tomkentpayne/wireless_gps_tracking/README.md

wireless_gps_tracking
=====================
