tomkentpayne/wireless_gps_tracking/Eagle/README.txt

Order number: 100021590

Note:
  Layers: 2
  Silk screen: top and bottom
  Soldermask: top and bottom
  File "car.GML" is the board outline
  Drill format: Excellon, 2.4 precision.
