tomkentpayne/wireless_gps_tracking/Server/route.PNG

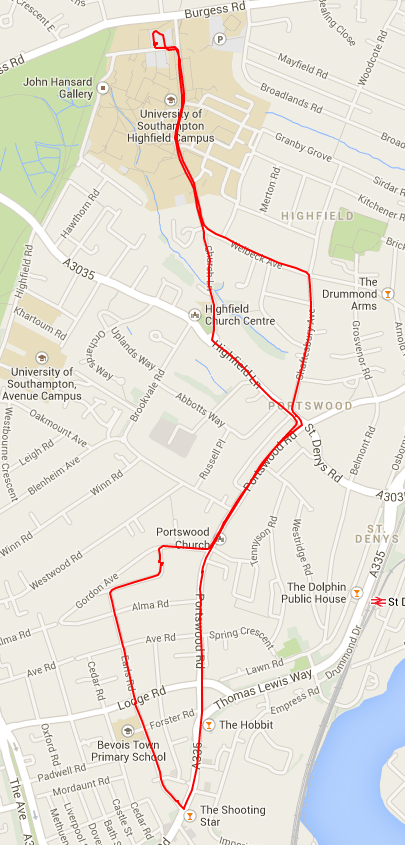
Server/route.PNG
