tomkentpayne/wireless_gps_tracking/Device Code/MAIN/Build/wireless.htm

# Static Call Graph for image .\Build\wireless.axf

#<CALLGRAPH># ARM Linker, 5.03 [Build 76]: Last Updated: Fri Dec 06 12:32:55 2013

### Maximum Stack Usage = 20 bytes + Unknown(Cycles, Untraceable Function Pointers)

### Call chain for Maximum Stack Depth:

SystemInit ⇒ SetSysClock

### Mutually Recursive functions

- ADC_IRQHandler ⇒ ADC_IRQHandler
- BusFault_Handler ⇒ BusFault_Handler
- HardFault_Handler ⇒ HardFault_Handler
- MemManage_Handler ⇒ MemManage_Handler
- UsageFault_Handler ⇒ UsageFault_Handler
- main ⇒ main

### Function Pointers

- ADC_IRQHandler from startup_stm32f40xx.o(.text) referenced from startup_stm32f40xx.o(RESET)
- BusFault_Handler from stm32f4xx_it.o(i.BusFault_Handler) referenced from startup_stm32f40xx.o(RESET)
- CAN1_RX0_IRQHandler from startup_stm32f40xx.o(.text) referenced from startup_stm32f40xx.o(RESET)
- CAN1_RX1_IRQHandler from startup_stm32f40xx.o(.text) referenced from startup_stm32f40xx.o(RESET)
- CAN1_SCE_IRQHandler from startup_stm32f40xx.o(.text) referenced from startup_stm32f40xx.o(RESET)
- CAN1_TX_IRQHandler from startup_stm32f40xx.o(.text) referenced from startup_stm32f40xx.o(RESET)
- CAN2_RX0_IRQHandler from startup_stm32f40xx.o(.text) referenced from startup_stm32f40xx.o(RESET)
- CAN2_RX1_IRQHandler from startup_stm32f40xx.o(.text) referenced from startup_stm32f40xx.o(RESET)
- CAN2_SCE_IRQHandler from startup_stm32f40xx.o(.text) referenced from startup_stm32f40xx.o(RESET)
- CAN2_TX_IRQHandler from startup_stm32f40xx.o(.text) referenced from startup_stm32f40xx.o(RESET)
- CRYP_IRQHandler from startup_stm32f40xx.o(.text) referenced from startup_stm32f40xx.o(RESET)
- DCMI_IRQHandler from startup_stm32f40xx.o(.text) referenced from startup_stm32f40xx.o(RESET)
- DMA1_Stream0_IRQHandler from startup_stm32f40xx.o(.text) referenced from startup_stm32f40xx.o(RESET)
- DMA1_Stream1_IRQHandler from startup_stm32f40xx.o(.text) referenced from startup_stm32f40xx.o(RESET)
- DMA1_Stream2_IRQHandler from startup_stm32f40xx.o(.text) referenced from startup_stm32f40xx.o(RESET)
- DMA1_Stream3_IRQHandler from startup_stm32f40xx.o(.text) referenced from startup_stm32f40xx.o(RESET)
- DMA1_Stream4_IRQHandler from startup_stm32f40xx.o(.text) referenced from startup_stm32f40xx.o(RESET)
- DMA1_Stream5_IRQHandler from startup_stm32f40xx.o(.text) referenced from startup_stm32f40xx.o(RESET)
- DMA1_Stream6_IRQHandler from startup_stm32f40xx.o(.text) referenced from startup_stm32f40xx.o(RESET)
- DMA1_Stream7_IRQHandler from startup_stm32f40xx.o(.text) referenced from startup_stm32f40xx.o(RESET)
- DMA2_Stream0_IRQHandler from startup_stm32f40xx.o(.text) referenced from startup_stm32f40xx.o(RESET)
- DMA2_Stream1_IRQHandler from startup_stm32f40xx.o(.text) referenced from startup_stm32f40xx.o(RESET)
- DMA2_Stream2_IRQHandler from startup_stm32f40xx.o(.text) referenced from startup_stm32f40xx.o(RESET)
- DMA2_Stream3_IRQHandler from startup_stm32f40xx.o(.text) referenced from startup_stm32f40xx.o(RESET)
- DMA2_Stream4_IRQHandler from startup_stm32f40xx.o(.text) referenced from startup_stm32f40xx.o(RESET)
- DMA2_Stream5_IRQHandler from startup_stm32f40xx.o(.text) referenced from startup_stm32f40xx.o(RESET)
- DMA2_Stream6_IRQHandler from startup_stm32f40xx.o(.text) referenced from startup_stm32f40xx.o(RESET)
- DMA2_Stream7_IRQHandler from startup_stm32f40xx.o(.text) referenced from startup_stm32f40xx.o(RESET)
- DebugMon_Handler from stm32f4xx_it.o(i.DebugMon_Handler) referenced from startup_stm32f40xx.o(RESET)
- ETH_IRQHandler from startup_stm32f40xx.o(.text) referenced from startup_stm32f40xx.o(RESET)
- ETH_WKUP_IRQHandler from startup_stm32f40xx.o(.text) referenced from startup_stm32f40xx.o(RESET)
- EXTI0_IRQHandler from startup_stm32f40xx.o(.text) referenced from startup_stm32f40xx.o(RESET)
- EXTI15_10_IRQHandler from startup_stm32f40xx.o(.text) referenced from startup_stm32f40xx.o(RESET)
- EXTI1_IRQHandler from startup_stm32f40xx.o(.text) referenced from startup_stm32f40xx.o(RESET)
- EXTI2_IRQHandler from startup_stm32f40xx.o(.text) referenced from startup_stm32f40xx.o(RESET)
- EXTI3_IRQHandler from startup_stm32f40xx.o(.text) referenced from startup_stm32f40xx.o(RESET)
- EXTI4_IRQHandler from startup_stm32f40xx.o(.text) referenced from startup_stm32f40xx.o(RESET)
- EXTI9_5_IRQHandler from startup_stm32f40xx.o(.text) referenced from startup_stm32f40xx.o(RESET)
- FLASH_IRQHandler from startup_stm32f40xx.o(.text) referenced from startup_stm32f40xx.o(RESET)
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
- TIM8_CC_IRQHandler from startup_stm32f40xx.o(.text) referenced from startup_stm32f40xx.o(RESET)
- TIM8_TRG_COM_TIM14_IRQHandler from startup_stm32f40xx.o(.text) referenced from startup_stm32f40xx.o(RESET)
- TIM8_UP_TIM13_IRQHandler from startup_stm32f40xx.o(.text) referenced from startup_stm32f40xx.o(RESET)
- UART4_IRQHandler from startup_stm32f40xx.o(.text) referenced from startup_stm32f40xx.o(RESET)
- UART5_IRQHandler from startup_stm32f40xx.o(.text) referenced from startup_stm32f40xx.o(RESET)
- USART1_IRQHandler from startup_stm32f40xx.o(.text) referenced from startup_stm32f40xx.o(RESET)
- USART2_IRQHandler from startup_stm32f40xx.o(.text) referenced from startup_stm32f40xx.o(RESET)
- USART3_IRQHandler from startup_stm32f40xx.o(.text) referenced from startup_stm32f40xx.o(RESET)
- USART6_IRQHandler from startup_stm32f40xx.o(.text) referenced from startup_stm32f40xx.o(RESET)
- UsageFault_Handler from stm32f4xx_it.o(i.UsageFault_Handler) referenced from startup_stm32f40xx.o(RESET)
- WWDG_IRQHandler from startup_stm32f40xx.o(.text) referenced from startup_stm32f40xx.o(RESET)
- __main from entry.o(.ARM.Collect$$$$00000000) referenced from startup_stm32f40xx.o(.text)
- main from main.o(i.main) referenced from entry9a.o(.ARM.Collect$$$$0000000B)

### Global Symbols

__main (Thumb, 0 bytes, Stack size unknown bytes, entry.o(.ARM.Collect$$$$00000000))
[Address Reference Count : 1]

- startup_stm32f40xx.o(.text)

_main_stk (Thumb, 0 bytes, Stack size unknown bytes, entry2.o(.ARM.Collect$$$$00000001))

_main_scatterload (Thumb, 0 bytes, Stack size unknown bytes, entry5.o(.ARM.Collect$$$$00000004))

[Calls]

- >> __scatterload

__main_after_scatterload (Thumb, 0 bytes, Stack size unknown bytes, entry5.o(.ARM.Collect$$$$00000004))

[Called By]

- >> __scatterload

_main_clock (Thumb, 0 bytes, Stack size unknown bytes, entry7b.o(.ARM.Collect$$$$00000008))

_main_cpp_init (Thumb, 0 bytes, Stack size unknown bytes, entry8b.o(.ARM.Collect$$$$0000000A))

_main_init (Thumb, 0 bytes, Stack size unknown bytes, entry9a.o(.ARM.Collect$$$$0000000B))

__rt_final_cpp (Thumb, 0 bytes, Stack size unknown bytes, entry10a.o(.ARM.Collect$$$$0000000D))

__rt_final_exit (Thumb, 0 bytes, Stack size unknown bytes, entry11a.o(.ARM.Collect$$$$0000000F))

Reset_Handler (Thumb, 8 bytes, Stack size 0 bytes, startup_stm32f40xx.o(.text))
[Address Reference Count : 1]

- startup_stm32f40xx.o(RESET)

ADC_IRQHandler (Thumb, 0 bytes, Stack size 0 bytes, startup_stm32f40xx.o(.text))

[Calls]

- >> ADC_IRQHandler

[Called By]

- >> ADC_IRQHandler

[Address Reference Count : 1]

- startup_stm32f40xx.o(RESET)

CAN1_RX0_IRQHandler (Thumb, 0 bytes, Stack size 0 bytes, startup_stm32f40xx.o(.text))
[Address Reference Count : 1]

- startup_stm32f40xx.o(RESET)

CAN1_RX1_IRQHandler (Thumb, 0 bytes, Stack size 0 bytes, startup_stm32f40xx.o(.text))
[Address Reference Count : 1]

- startup_stm32f40xx.o(RESET)

CAN1_SCE_IRQHandler (Thumb, 0 bytes, Stack size 0 bytes, startup_stm32f40xx.o(.text))
[Address Reference Count : 1]

- startup_stm32f40xx.o(RESET)

CAN1_TX_IRQHandler (Thumb, 0 bytes, Stack size 0 bytes, startup_stm32f40xx.o(.text))
[Address Reference Count : 1]

- startup_stm32f40xx.o(RESET)

CAN2_RX0_IRQHandler (Thumb, 0 bytes, Stack size 0 bytes, startup_stm32f40xx.o(.text))
[Address Reference Count : 1]

- startup_stm32f40xx.o(RESET)

CAN2_RX1_IRQHandler (Thumb, 0 bytes, Stack size 0 bytes, startup_stm32f40xx.o(.text))
[Address Reference Count : 1]

- startup_stm32f40xx.o(RESET)

CAN2_SCE_IRQHandler (Thumb, 0 bytes, Stack size 0 bytes, startup_stm32f40xx.o(.text))
[Address Reference Count : 1]

- startup_stm32f40xx.o(RESET)

CAN2_TX_IRQHandler (Thumb, 0 bytes, Stack size 0 bytes, startup_stm32f40xx.o(.text))
[Address Reference Count : 1]

- startup_stm32f40xx.o(RESET)

CRYP_IRQHandler (Thumb, 0 bytes, Stack size 0 bytes, startup_stm32f40xx.o(.text))
[Address Reference Count : 1]

- startup_stm32f40xx.o(RESET)

DCMI_IRQHandler (Thumb, 0 bytes, Stack size 0 bytes, startup_stm32f40xx.o(.text))
[Address Reference Count : 1]

- startup_stm32f40xx.o(RESET)

DMA1_Stream0_IRQHandler (Thumb, 0 bytes, Stack size 0 bytes, startup_stm32f40xx.o(.text))
[Address Reference Count : 1]

- startup_stm32f40xx.o(RESET)

DMA1_Stream1_IRQHandler (Thumb, 0 bytes, Stack size 0 bytes, startup_stm32f40xx.o(.text))
[Address Reference Count : 1]

- startup_stm32f40xx.o(RESET)

DMA1_Stream2_IRQHandler (Thumb, 0 bytes, Stack size 0 bytes, startup_stm32f40xx.o(.text))
[Address Reference Count : 1]

- startup_stm32f40xx.o(RESET)

DMA1_Stream3_IRQHandler (Thumb, 0 bytes, Stack size 0 bytes, startup_stm32f40xx.o(.text))
[Address Reference Count : 1]

- startup_stm32f40xx.o(RESET)

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

BusFault_Handler (Thumb, 2 bytes, Stack size 0 bytes, stm32f4xx_it.o(i.BusFault_Handler))

[Calls]

- >> BusFault_Handler

[Called By]

- >> BusFault_Handler

[Address Reference Count : 1]

- startup_stm32f40xx.o(RESET)

DebugMon_Handler (Thumb, 2 bytes, Stack size 0 bytes, stm32f4xx_it.o(i.DebugMon_Handler))
[Address Reference Count : 1]

- startup_stm32f40xx.o(RESET)

HardFault_Handler (Thumb, 2 bytes, Stack size 0 bytes, stm32f4xx_it.o(i.HardFault_Handler))

[Calls]

- >> HardFault_Handler

[Called By]

- >> HardFault_Handler

[Address Reference Count : 1]

- startup_stm32f40xx.o(RESET)

MemManage_Handler (Thumb, 2 bytes, Stack size 0 bytes, stm32f4xx_it.o(i.MemManage_Handler))

[Calls]

- >> MemManage_Handler

[Called By]

- >> MemManage_Handler

[Address Reference Count : 1]

- startup_stm32f40xx.o(RESET)

NMI_Handler (Thumb, 2 bytes, Stack size 0 bytes, stm32f4xx_it.o(i.NMI_Handler))
[Address Reference Count : 1]

- startup_stm32f40xx.o(RESET)

PendSV_Handler (Thumb, 2 bytes, Stack size 0 bytes, stm32f4xx_it.o(i.PendSV_Handler))
[Address Reference Count : 1]

- startup_stm32f40xx.o(RESET)

SVC_Handler (Thumb, 2 bytes, Stack size 0 bytes, stm32f4xx_it.o(i.SVC_Handler))
[Address Reference Count : 1]

- startup_stm32f40xx.o(RESET)

SysTick_Handler (Thumb, 2 bytes, Stack size 0 bytes, stm32f4xx_it.o(i.SysTick_Handler))
[Address Reference Count : 1]

- startup_stm32f40xx.o(RESET)

SystemInit (Thumb, 62 bytes, Stack size 8 bytes, system_stm32f4xx.o(i.SystemInit))

[Stack]

- Max Depth = 20
- Call Chain = SystemInit ⇒ SetSysClock

[Calls]

- >> SetSysClock

[Address Reference Count : 1]

- startup_stm32f40xx.o(.text)

UsageFault_Handler (Thumb, 2 bytes, Stack size 0 bytes, stm32f4xx_it.o(i.UsageFault_Handler))

[Calls]

- >> UsageFault_Handler

[Called By]

- >> UsageFault_Handler

[Address Reference Count : 1]

- startup_stm32f40xx.o(RESET)

__scatterload_copy (Thumb, 14 bytes, Stack size unknown bytes, handlers.o(i.__scatterload_copy), UNUSED)

__scatterload_null (Thumb, 2 bytes, Stack size unknown bytes, handlers.o(i.__scatterload_null), UNUSED)

__scatterload_zeroinit (Thumb, 14 bytes, Stack size unknown bytes, handlers.o(i.__scatterload_zeroinit), UNUSED)

main (Thumb, 2 bytes, Stack size 0 bytes, main.o(i.main))

[Calls]

- >> main

[Called By]

- >> main

[Address Reference Count : 1]

- entry9a.o(.ARM.Collect$$$$0000000B)

### Local Symbols

SetSysClock (Thumb, 162 bytes, Stack size 12 bytes, system_stm32f4xx.o(i.SetSysClock))

[Stack]

- Max Depth = 12
- Call Chain = SetSysClock

[Called By]

- >> SystemInit

### Undefined Global Symbols
