tomkentpayne/wireless_gps_tracking/Eagle/car.bcl.pdf

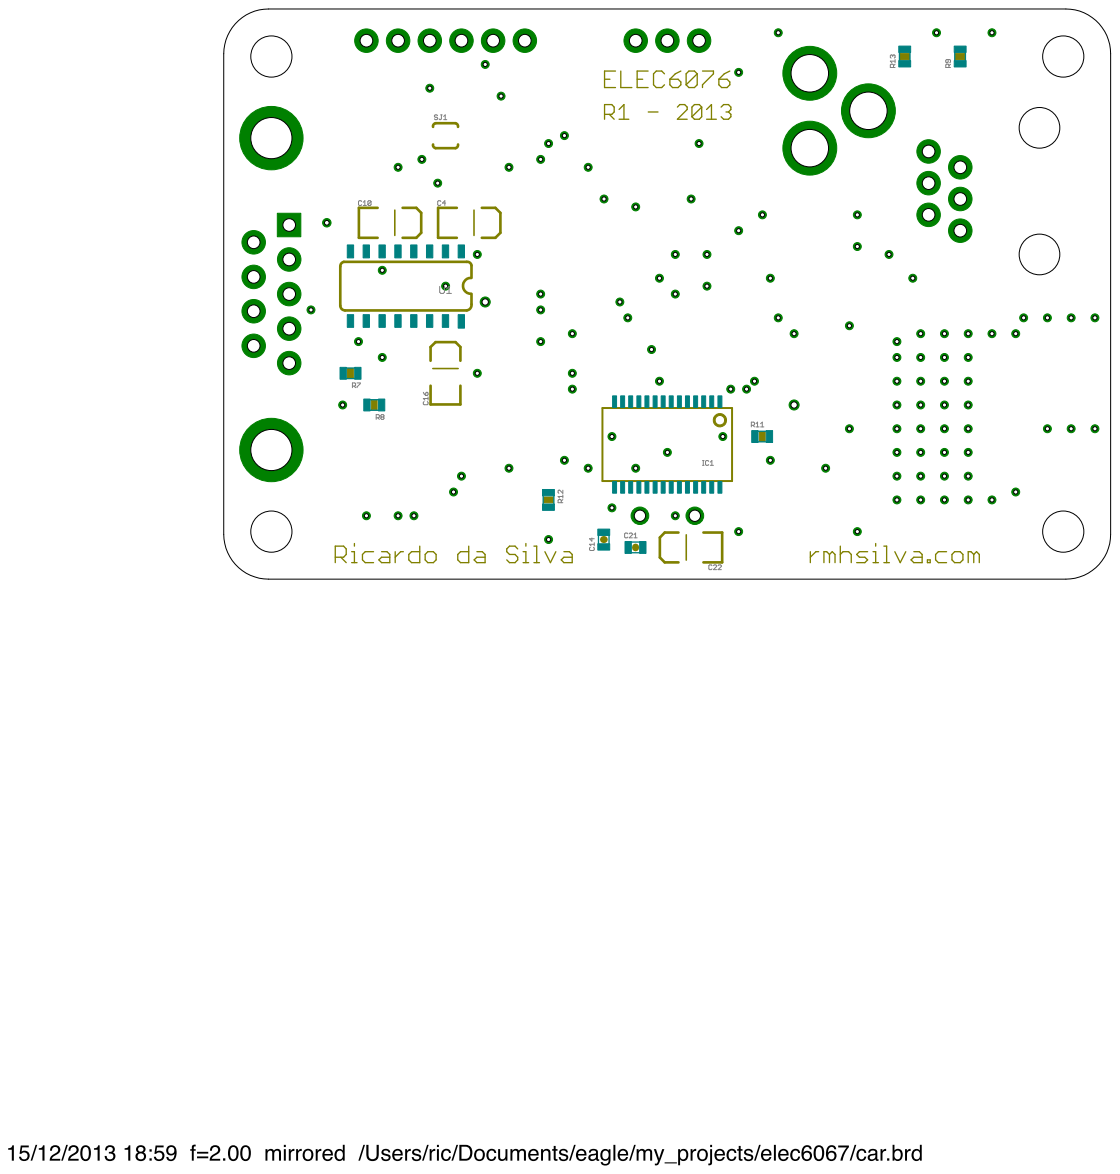
[picture p2: page 1]
