tomkentpayne/wireless_gps_tracking/Eagle/car.pdf

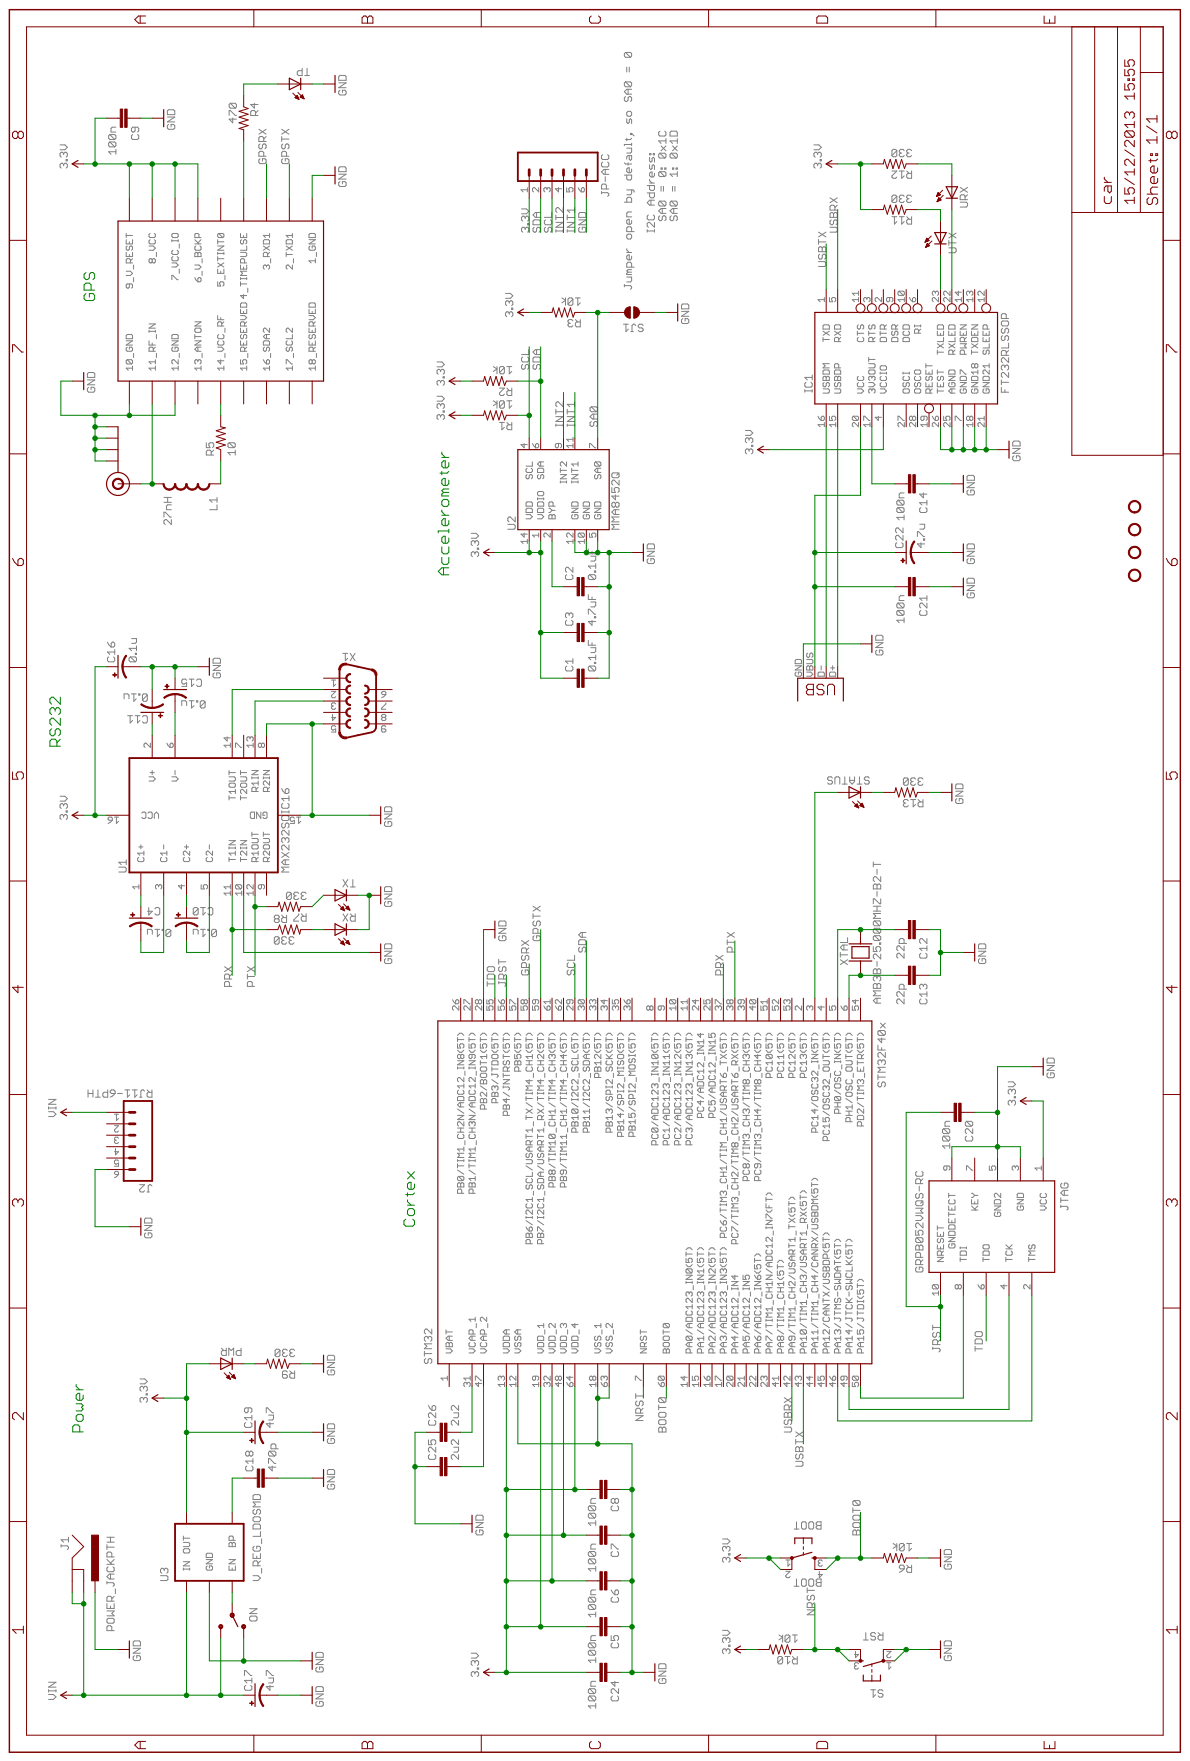
[picture p3: page 1]
