tomkentpayne/wireless_gps_tracking/Eagle/car.tcl.pdf

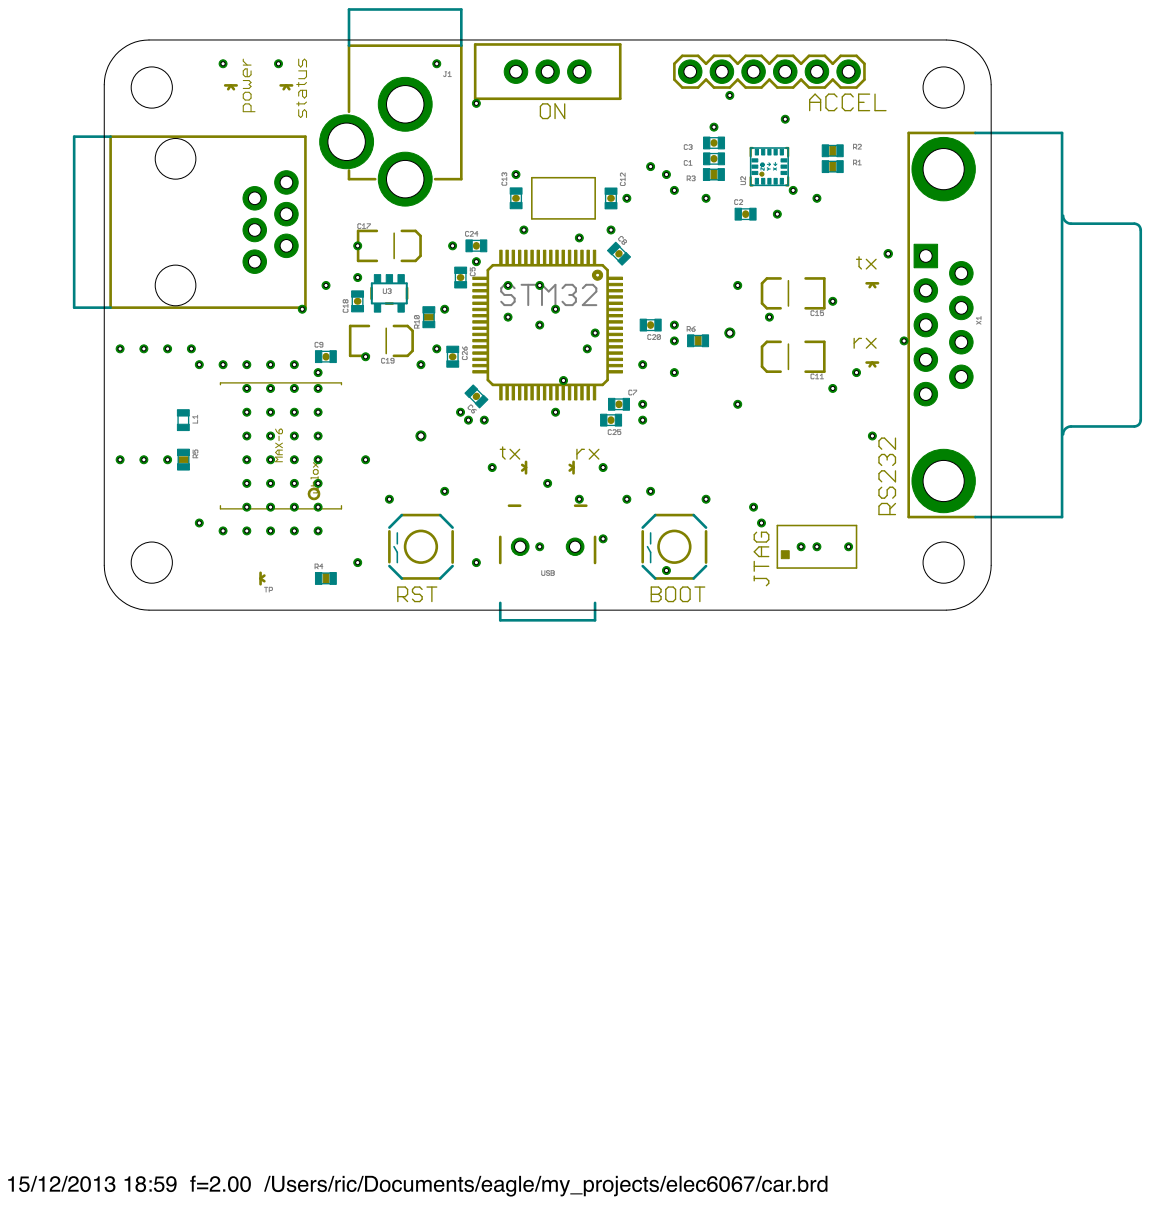
[picture p4: page 1]
