tomkentpayne/wireless_gps_tracking/Eagle/car.brd

## EAGLE design Eagle/car.brd (2013-12-23)

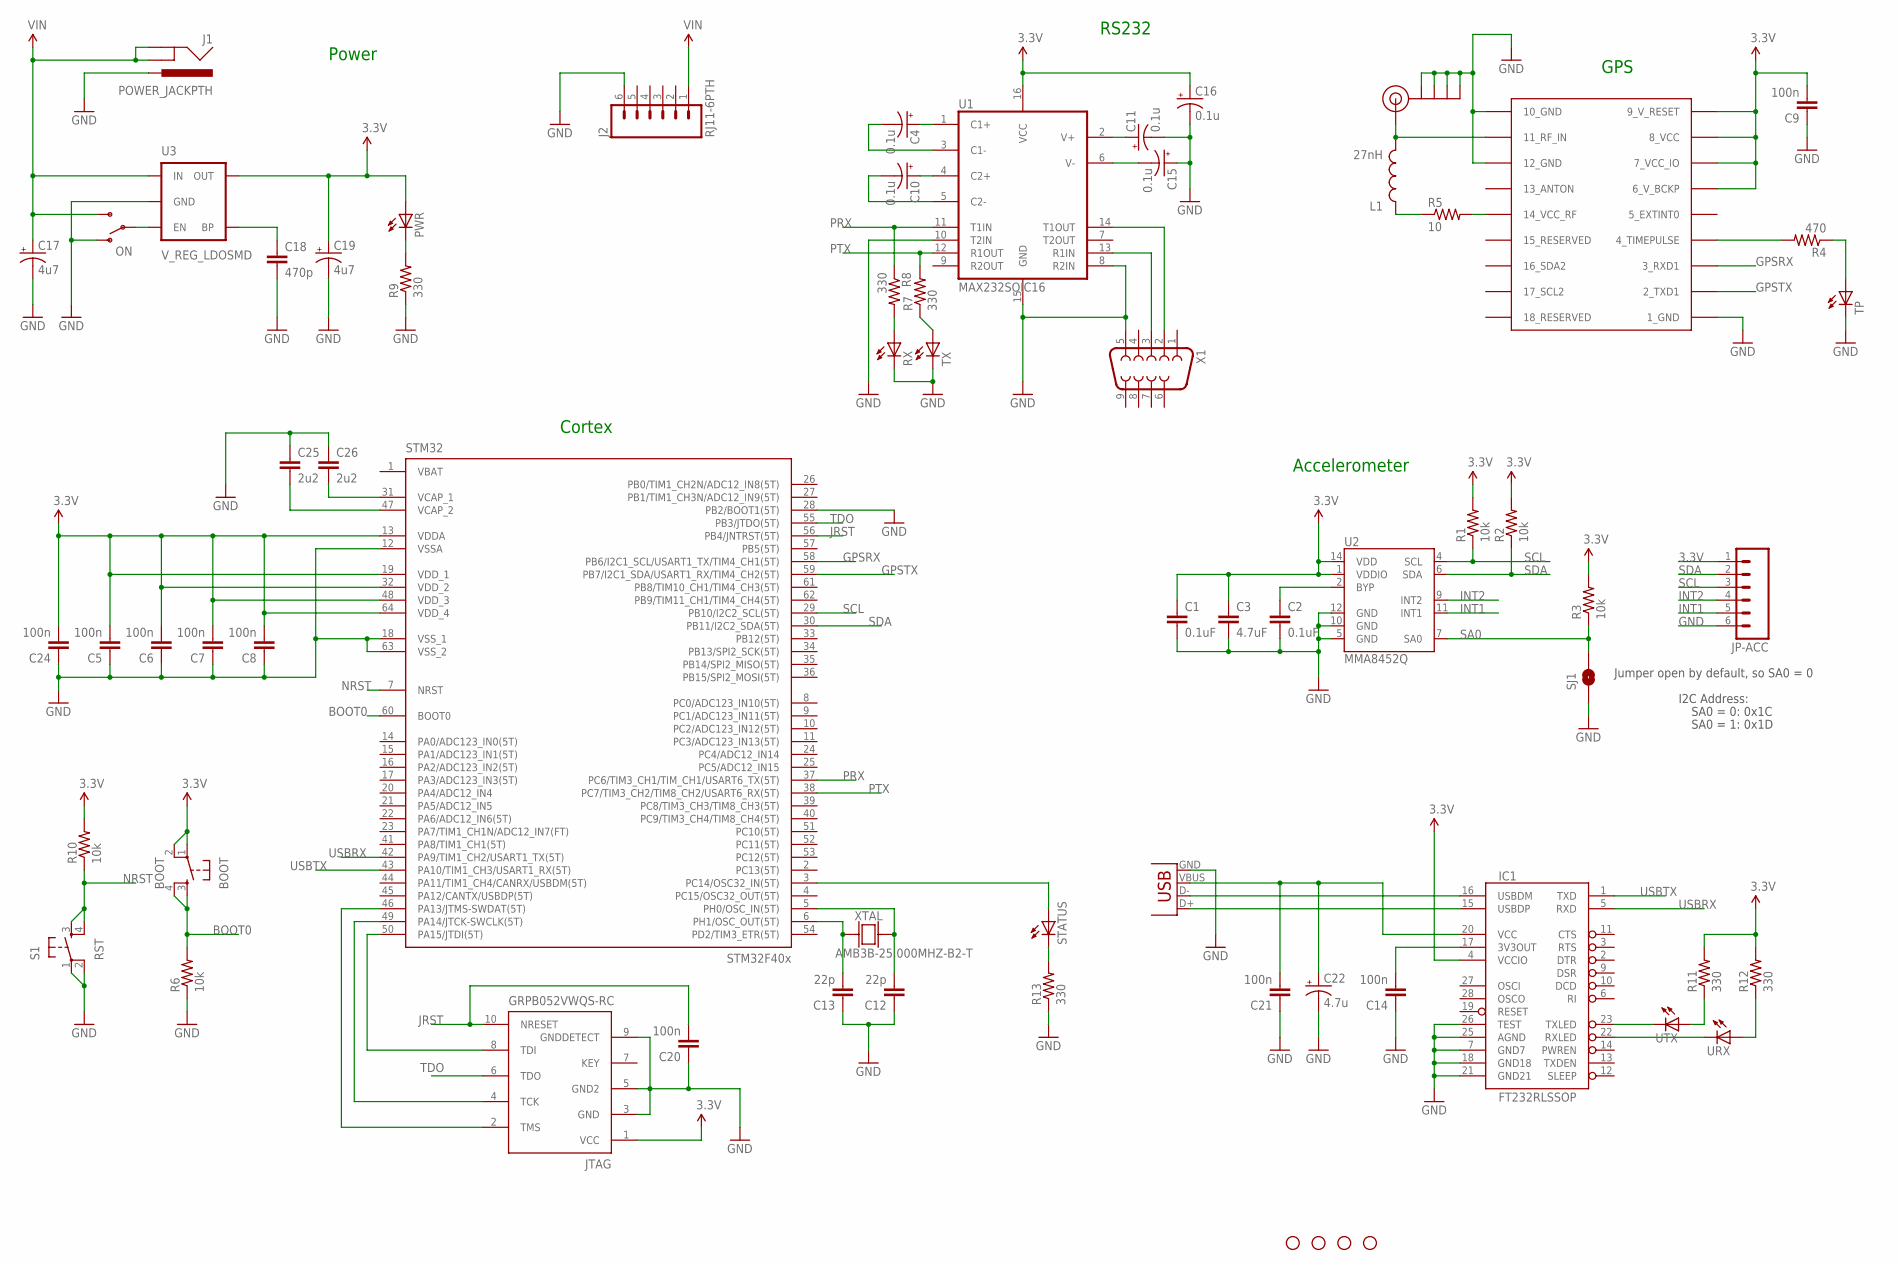
[picture p5: schematic car.sch]

Parts:
BOOT: BOOT; TACTILE_SWITCH_SMD
C1, C2: 0.1uF; 0603-CAP
C3: 4.7uF; 0603-CAP
C4, C10, C11, C15, C16: 0.1u; EIA3216
C5, C6, C7, C8, C9, C14, C20, C21, C24: 100n; 0603-CAP
C12, C13: 22p; 0603-CAP
C17, C19: 4u7; EIA3216
C18: 470p; 0603-CAP
C22: 4.7u; EIA3216
C25, C26: 2u2; 0603-CAP
IC1: FT232RLSSOP; SSOP28DB
J1: POWER_JACKPTH; POWER_JACK_PTH
J2: RJ11-6PTH; RJ11-6
J$1: SMA_EDGE; SMA-EDGE
JP1, JP2, JP3, JP4: STAND-OFF
JP-ACC: M06SIP; 1X06
JTAG: GRPB052VWQS-RC; DEBUG
L1: 27nH; 0603
ON: SWITCH-SPDTPTH; SWITCH-SPDT
PWR: LED0603; LED-0603
R1, R2, R3, R6, R10: 10k; 0603-RES
R4: 470; 0603-RES
R5: 10; 0603-RES
R7, R8, R9, R11, R12, R13: 330; 0603-RES
RX: LED0603; LED-0603
S1: RST; TACTILE_SWITCH_SMD
SJ1: SOLDERJUMPERNO; SJ_2S-NO
STATUS: LED0603; LED-0603
STM32: STM32F405R; TQFP64
TP: LED0603; LED-0603
TX: LED0603; LED-0603
U1: MAX232SOIC16; SO016
U2: MMA8452Q; QFN-16_0.5MM
U3: V_REG_LDOSMD; SOT23-5
U$1: UBLOX_MAX-6
URX: LED0603; LED-0603
USB: USB-SMD-NS; USB-MINIB-NOSTOP
UTX: LED0603; LED-0603
X1: DB9FEMALE; DB9
XTAL: AMB3B-25.000MHZ-B2-T; 4LCC

Connections:
3.3V: BOOT.1, BOOT.2, C1.1, C3.1, C5.2, C6.2, C7.2, C8.2, C9.2, C16.A (+), C19.A (+), C24.2, IC1.4 (VCCIO), JP-ACC.1, JTAG.1 (VCC), PWR.A, R1.2, R2.2, R3.2, R10.2, R11.2, R12.2, STM32.13 (VDDA), STM32.19 (VDD_1), STM32.32 (VDD_2), STM32.48 (VDD_3), STM32.64 (VDD_4), U1.16 (VCC), U2.1 (VDDIO), U2.14 (VDD), U3.5 (OUT), U$1.6_V_BCKP, U$1.7_VCC_IO, U$1.8_VCC, U$1.9_V_RESET
3.3V1: STATUS.A, STM32.3 (PC14/OSC32_IN(5T))
BOOT0: BOOT.3, BOOT.4, R6.2, STM32.60 (BOOT0)
BYP: C2.1, U2.2 (BYP)
GND: C1.2, C2.2, C3.2, C5.1, C6.1, C7.1, C8.1, C9.1, C11.C (-), C12.1, C13.1, C14.1, C15.A (+), C16.C (-), C17.C (-), C18.2, C19.C (-), C20.1, C21.1, C22.C (-), C24.1, C25.1, C26.1, IC1.7 (GND7), IC1.18 (GND18), IC1.21 (GND21), IC1.25 (AGND), IC1.26 (TEST), J1.PWR, J2.6, J$1.GND@0 (GND), J$1.GND@1 (GND), J$1.GND@2 (GND), J$1.GND@3 (GND), JP-ACC.6, JTAG.3 (GND), JTAG.5 (GND2), JTAG.9 (GNDDETECT), ON.1 (O), R6.1, R9.1, R13.1, RX.C, S1.1, S1.2, SJ1.1, STM32.12 (VSSA), STM32.18 (VSS_1), STM32.28 (PB2/BOOT1(5T)), STM32.63 (VSS_2), TP.C, TX.C, U1.8 (R2IN), U1.10 (T2IN), U1.15 (GND), U2.5 (GND), U2.10 (GND), U2.12 (GND), U3.2 (GND), U$1.1_GND, U$1.10_GND, U$1.12_GND, USB.GND, X1.5
GPSRX: STM32.58 (PB6/I2C1_SCL/USART1_TX/TIM4_CH1(5T)), U$1.3_RXD1
GPSTX: STM32.59 (PB7/I2C1_SDA/USART1_RX/TIM4_CH2(5T)), U$1.2_TXD1
INT1: JP-ACC.5, U2.11 (INT1)
INT2: JP-ACC.4, U2.9 (INT2)
JRST: C20.2, JTAG.10 (NRESET), STM32.56 (PB4/JNTRST(5T))
unnamed: U1.14 (T1OUT), X1.2
unnamed: R4.1, TP.A
unnamed: R4.2, U$1.4_TIMEPULSE
unnamed: C15.C (-), U1.6 (V-)
unnamed: L1.1, R5.1
unnamed: R5.2, U$1.14_VCC_RF
unnamed: J$1.SIG (SIGNAL), L1.2, U$1.11_RF_IN
unnamed: C12.2, STM32.5 (PH0/OSC_IN(5T)), XTAL.3
unnamed: PWR.C, R9.2
unnamed: C11.A (+), U1.2 (V+)
unnamed: C4.A (+), U1.1 (C1+)
unnamed: C4.C (-), U1.3 (C1-)
unnamed: C10.A (+), U1.4 (C2+)
unnamed: C10.C (-), U1.5 (C2-)
unnamed: U1.13 (R1IN), X1.3
unnamed: R7.1, TX.A
unnamed: R8.2, RX.A
unnamed: C13.2, STM32.6 (PH1/OSC_OUT(5T)), XTAL.1
unnamed: C18.1, U3.4 (BP)
unnamed: R13.2, STATUS.C
unnamed: C26.2, STM32.31 (VCAP_1)
unnamed: ON.2, U3.3 (EN)
unnamed: IC1.16 (USBDM), USB.D-
unnamed: IC1.15 (USBDP), USB.D+
unnamed: C21.2, C22.A (+), IC1.20 (VCC), USB.VBUS
unnamed: IC1.23 (TXLED), UTX.C
unnamed: IC1.22 (RXLED), URX.C
unnamed: R11.1, UTX.A
unnamed: R12.1, URX.A
unnamed: C25.2, STM32.47 (VCAP_2)
unnamed: C14.2, IC1.17 (3V3OUT)
NRST: R10.1, S1.3, S1.4, STM32.7 (NRST)
PRX: R8.1, STM32.37 (PC6/TIM3_CH1/TIM_CH1/USART6_TX(5T)), U1.11 (T1IN)
PTX: R7.2, STM32.38 (PC7/TIM3_CH2/TIM8_CH2/USART6_RX(5T)), U1.12 (R1OUT)
SA0: R3.1, SJ1.2, U2.7 (SA0)
SCL: JP-ACC.3, R1.1, STM32.29 (PB10/I2C2_SCL(5T)), U2.4 (SCL)
SDA: JP-ACC.2, R2.1, STM32.30 (PB11/I2C2_SDA(5T)), U2.6 (SDA)
TCK: JTAG.4 (TCK), STM32.49 (PA14/JTCK-SWCLK(5T))
TDI: JTAG.8 (TDI), STM32.50 (PA15/JTDI(5T))
TDO: JTAG.6 (TDO), STM32.55 (PB3/JTDO(5T))
TMS: JTAG.2 (TMS), STM32.46 (PA13/JTMS-SWDAT(5T))
USBRX: IC1.5 (RXD), STM32.42 (PA9/TIM1_CH2/USART1_TX(5T))
USBTX: IC1.1 (TXD), STM32.43 (PA10/TIM1_CH3/USART1_RX(5T))
VIN: C17.A (+), J1.GND, J1.GNDBREAK, J2.1, ON.3 (S), U3.1 (IN)

Notes on the sheet:
I2C Address:
SA0 = 0: 0x1C
SA0 = 1: 0x1D
Jumper open by default, so SA0 = 0
Accelerometer
Power
GPS
RS232
Cortex

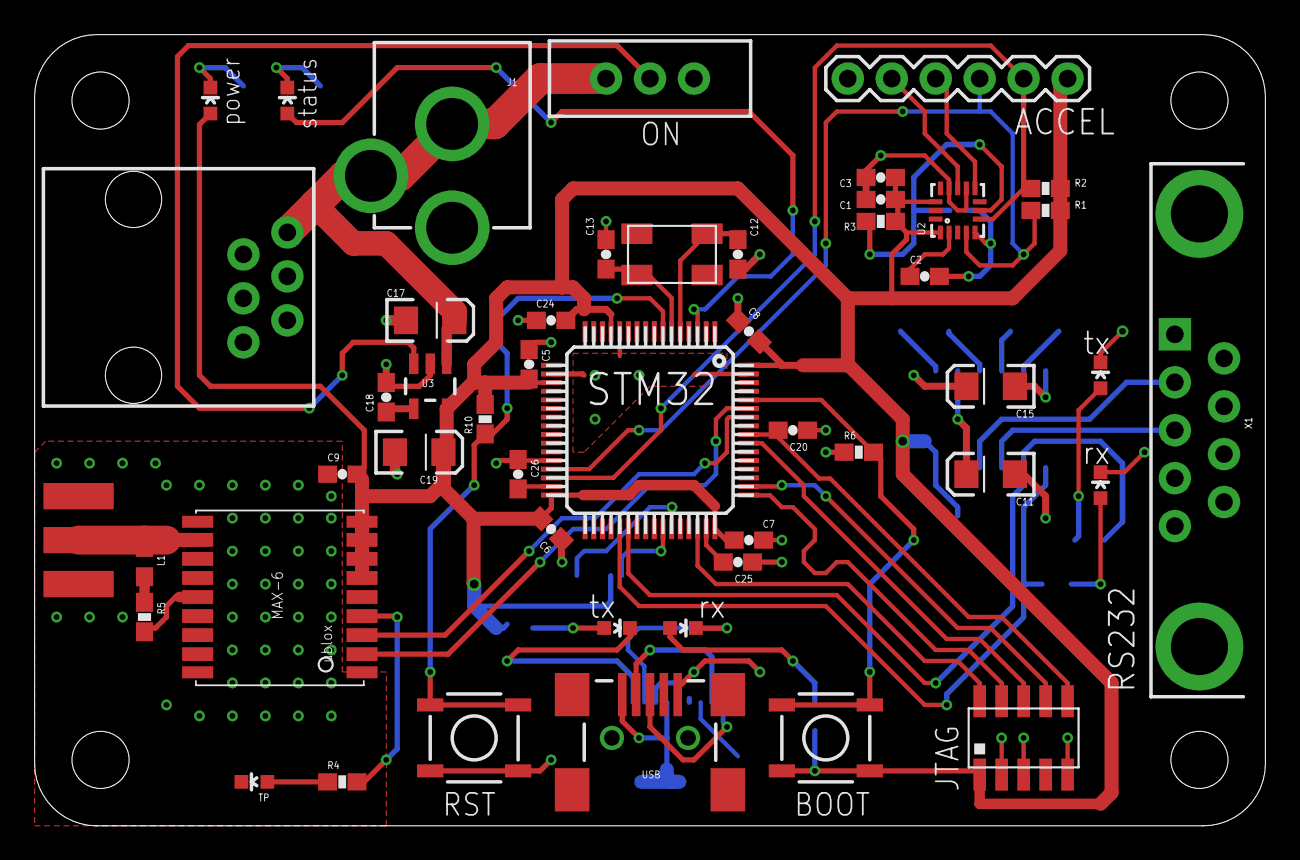
[picture p6: board car.brd from above]

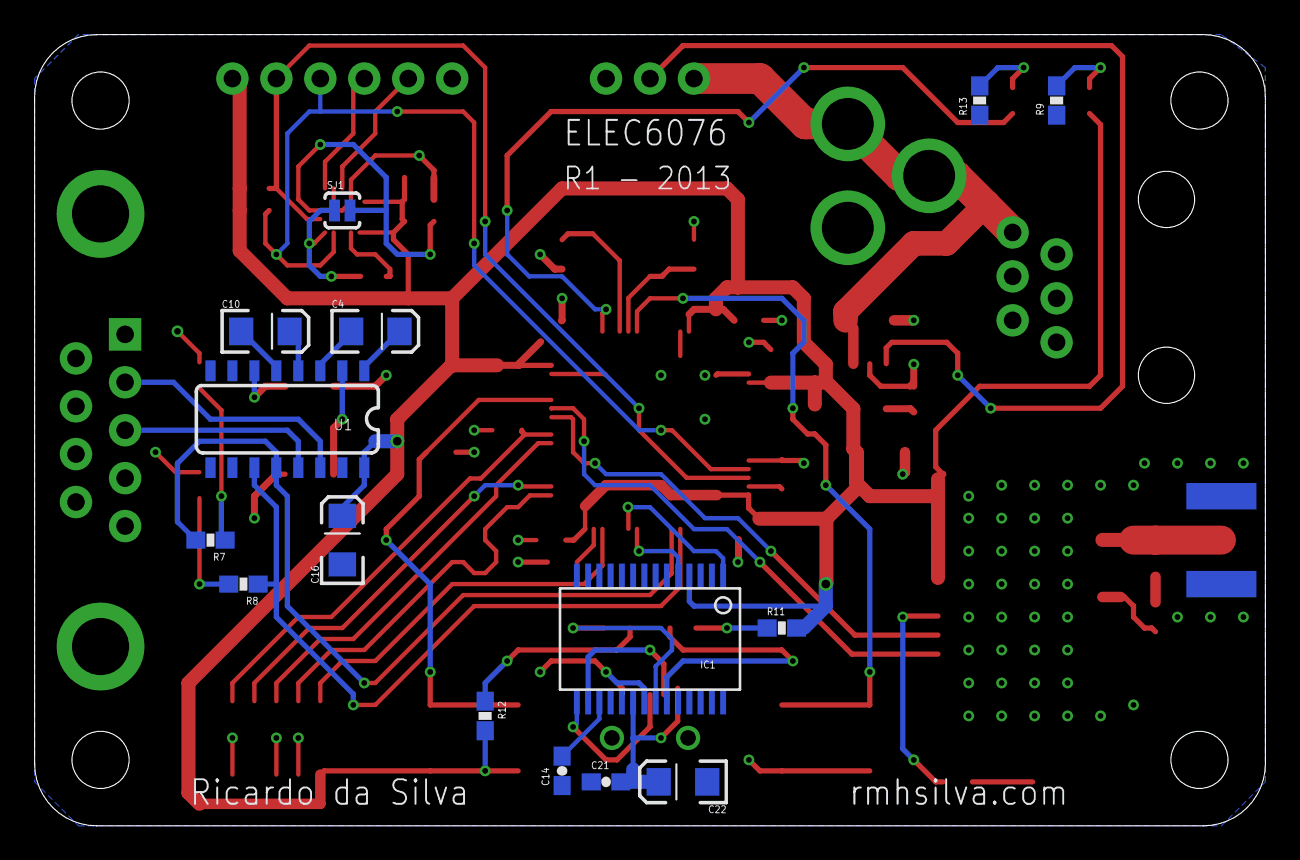
[picture p7: board car.brd from below]

Board: 2 copper layers, 71.1 x 45.7 mm, 68 parts (15 on the bottom side), 54 nets.
