tomkentpayne/wireless_gps_tracking/Device Code/MAIN/User/serial.c

/* USART serial code
* used by GPS, GPRS comms
* maintained by Thomas Payne tp8g10
*/

#include <stm32f4xx.h>
#include <misc.h>
#include <stm32f4xx_usart.h>
#include <stm32f4xx_dma.h>
#include <stdio.h>
#include <string.h>
#include "serial.h"
#include "globals.h"

/*
* PINS
* GPS: USART1 PB6 Tx, PB7 Rx
* USB: USART1 PA9 Tx, PA10 Rx
*/

#define MESSAGE_NO_FIX "$GPGLL,,,,,104439.00,V,N*"
#define MESSAGE_FIX "$GPGLL,5056.27340,N,00123.88000,W,104503.00,A,A*"

/* Private variables */
static char received_string[MAX_STRLEN]; /* String received over USART */
char nmea_data[MAX_GPS_STRLEN]; /* GPS nmea data, before lat/long extracted */
static char Buffer1[MAXUSARTBUF];
static char Buffer3[MAXUSARTBUF];
static char Buffer6[MAXUSARTBUF];
static uint8_t uart1virgin=1; /* no virgins were used in the making of this function */
static uint8_t uart6virgin=1; /* no virgins were used in the making of this function */
static DMA_InitTypeDef  DMA_InitStructure;

/* Private Functions */
int8_t USART_init(USART_TypeDef* USARTx, uint32_t baudrate);
void init_USART1(uint32_t baudrate);

/* Initialisation function for serial peripherals */
int8_t Serial_init(void)
{
	if( USART_init(USART1, 115200) != 0 ) /* USART1, USB */
		return -1; /* USART init failed */
	if( USART_init(USART6, 9600) != 0 ) /* USART6, GPRS/RS232 */
		return -1; /* USART init failed */
	if( USART_init(USART3, 9600) != 0 ) /* USART6, GPRS/RS232 */
		return -1; /* USART init failed */
	
	strcpy(nmea_data, MESSAGE_FIX);

	return 0;
}

void USART_puts(USART_TypeDef* USARTx, volatile char *s){

	while(*s)
	{
		// wait until data register is empty
		while( !(USARTx->SR & 0x00000040) );
		USART_SendData(USARTx, *s);
		*s++;
	}
}

/*
* Return most recent received nmea_data string
*/
char* NMEA_data(void)
{
	//return MESSAGE_FIX;
	return nmea_data;
}

// void USART1_IRQHandler(void){

// 	// check if the USART1 receive interrupt flag was set
// 	if( USART_GetITStatus(USART1, USART_IT_RXNE) ){

// 		static uint8_t cnt = 0; // this counter is used to determine the string length
// 		char t = USART1->DR; // the character from the USART1 data register is saved in t

		/* check if the received character is not the LF character (used to determine end of string)
		 * or the if the maximum string length has been been reached
		 */
// 		if( (t != 'n') && (cnt < MAX_STRLEN) ){
// 			received_string[cnt] = t;
// 			cnt++;
// 		}
// 		else{ // otherwise reset the character counter and print the received string
// 			cnt = 0;
// 			USART_puts(USART1, received_string);
// 		}
// 	}
// }

/* Initialise USART port x at specified baudrate */
int8_t USART_init(USART_TypeDef* USARTx, uint32_t baudrate)
{
	GPIO_InitTypeDef  GPIO_InitStruct;		/* This is for the GPIO pins used as TX and RX */
	USART_InitTypeDef USART_InitStruct;		/* This is for the USART initilization */
	NVIC_InitTypeDef NVIC_InitStructure;	/* This is used to configure the NVIC
											* (nested vector interrupt controller) */
	GPIO_TypeDef* GPIOx;					/* GPIO port used */

	if(USARTx == USART1) /* USB */
	{

		RCC_APB2PeriphClockCmd(RCC_APB2Periph_USART1, ENABLE);	/* Enable APB2 peripheral clock (USART1 is on it) */
		RCC_AHB1PeriphClockCmd(RCC_AHB1Periph_GPIOA, ENABLE);	/* Same for the gpio pins used */

		RCC_AHB1PeriphClockCmd(RCC_AHB1Periph_DMA2, ENABLE);	/* DMA1 clock enable */

		GPIO_InitStruct.GPIO_Pin = GPIO_Pin_9 | GPIO_Pin_10;	/* 9 is Tx, 10 is Rx */
		NVIC_InitStructure.NVIC_IRQChannel = USART1_IRQn;		 /* Configure the USART1 interrupts */
		GPIOx = GPIOA;
		GPIO_PinAFConfig(GPIOx, GPIO_PinSource9, GPIO_AF_USART1);
		GPIO_PinAFConfig(GPIOx, GPIO_PinSource10, GPIO_AF_USART1);

		/* DMA: */
 
		DMA_DeInit(DMA2_Stream7);
		DMA_StructInit(&DMA_InitStructure);
		DMA_InitStructure.DMA_Channel = DMA_Channel_4;
		DMA_InitStructure.DMA_DIR = DMA_DIR_MemoryToPeripheral; /* Transmit */
		DMA_InitStructure.DMA_Memory0BaseAddr = (uint32_t)Buffer1;
		DMA_InitStructure.DMA_BufferSize = (uint16_t)sizeof(Buffer1) - 1;
		DMA_InitStructure.DMA_PeripheralBaseAddr = (uint32_t)&(USART1->DR);
		DMA_InitStructure.DMA_PeripheralInc = DMA_PeripheralInc_Disable;
		DMA_InitStructure.DMA_MemoryInc = DMA_MemoryInc_Enable;
		DMA_InitStructure.DMA_PeripheralDataSize = DMA_PeripheralDataSize_Byte;
		DMA_InitStructure.DMA_MemoryDataSize = DMA_MemoryDataSize_Byte;
		DMA_InitStructure.DMA_Mode = DMA_Mode_Normal;
		DMA_InitStructure.DMA_Priority = DMA_Priority_Low;
		DMA_InitStructure.DMA_FIFOMode = DMA_FIFOMode_Disable; /* MAYBE ENABLE */
		DMA_InitStructure.DMA_FIFOThreshold = DMA_FIFOThreshold_HalfFull; /* MAYBE FUL NOT HALFFULL */
		DMA_InitStructure.DMA_MemoryBurst = DMA_MemoryBurst_Single;
		DMA_InitStructure.DMA_PeripheralBurst = DMA_PeripheralBurst_Single;
		DMA_Init(DMA2_Stream7, &DMA_InitStructure);
		/* Enable the USART Tx DMA request */
		USART_DMACmd(USART1, USART_DMAReq_Tx, ENABLE);
		
		/* Enable DMA Stream Transfer Complete interrupt */
		DMA_ITConfig(DMA2_Stream7, DMA_IT_TC, ENABLE);
		
		/* Enable the DMA USART1 Tx Stream */
		DMA_Cmd(DMA2_Stream7, ENABLE);
	}
	else if(USARTx == USART3) /* Re-done GPS */
	{

		RCC_APB1PeriphClockCmd(RCC_APB1Periph_USART3, ENABLE);	/* Enable APB2 peripheral clock (USART3 is on it) */
		RCC_AHB1PeriphClockCmd(RCC_AHB1Periph_GPIOB, ENABLE);	/* Same for the gpio pins used */

		RCC_AHB1PeriphClockCmd(RCC_AHB1Periph_DMA1, ENABLE);	/* DMA1 clock enable */

		GPIO_InitStruct.GPIO_Pin = GPIO_Pin_10 | GPIO_Pin_11;	/* 10 is Tx, 11 is Rx */
		NVIC_InitStructure.NVIC_IRQChannel = USART3_IRQn;		 /* Configure the USART3 interrupts */
		GPIOx = GPIOB;
		GPIO_PinAFConfig(GPIOx, GPIO_PinSource10, GPIO_AF_USART3);
		GPIO_PinAFConfig(GPIOx, GPIO_PinSource11, GPIO_AF_USART3);

		/* DMA: */
 
		DMA_DeInit(DMA1_Stream3);
		DMA_StructInit(&DMA_InitStructure);
		DMA_InitStructure.DMA_Channel = DMA_Channel_4;
		DMA_InitStructure.DMA_DIR = DMA_DIR_MemoryToPeripheral; /* Transmit */
		DMA_InitStructure.DMA_Memory0BaseAddr = (uint32_t)Buffer3;
		DMA_InitStructure.DMA_BufferSize = (uint16_t)sizeof(Buffer3) - 1;
		DMA_InitStructure.DMA_PeripheralBaseAddr = (uint32_t)&(USART3->DR);
		DMA_InitStructure.DMA_PeripheralInc = DMA_PeripheralInc_Disable;
		DMA_InitStructure.DMA_MemoryInc = DMA_MemoryInc_Enable;
		DMA_InitStructure.DMA_PeripheralDataSize = DMA_PeripheralDataSize_Byte;
		DMA_InitStructure.DMA_MemoryDataSize = DMA_MemoryDataSize_Byte;
		DMA_InitStructure.DMA_Mode = DMA_Mode_Normal;
		DMA_InitStructure.DMA_Priority = DMA_Priority_Low;
		DMA_InitStructure.DMA_FIFOMode = DMA_FIFOMode_Disable; /* MAYBE ENABLE */
		DMA_InitStructure.DMA_FIFOThreshold = DMA_FIFOThreshold_HalfFull; /* MAYBE FUL NOT HALFFULL */
		DMA_InitStructure.DMA_MemoryBurst = DMA_MemoryBurst_Single;
		DMA_InitStructure.DMA_PeripheralBurst = DMA_PeripheralBurst_Single;
		DMA_Init(DMA1_Stream3, &DMA_InitStructure);
		/* Enable the USART Tx DMA request */
		USART_DMACmd(USART3, USART_DMAReq_Tx, ENABLE);
		
		/* Enable DMA Stream Transfer Complete interrupt */
		DMA_ITConfig(DMA1_Stream3, DMA_IT_TC, ENABLE);
		
		/* Enable the DMA USART1 Tx Stream */
		DMA_Cmd(DMA1_Stream3, ENABLE);
	}
	else if(USARTx == USART6) /* RS232 */
	{

		RCC_APB2PeriphClockCmd(RCC_APB2Periph_USART6, ENABLE);	/* Enable APB2 peripheral clock (USART1 is on it) */
		RCC_AHB1PeriphClockCmd(RCC_AHB1Periph_GPIOC, ENABLE);	/* Same for the gpio pins used */

		RCC_AHB1PeriphClockCmd(RCC_AHB1Periph_DMA2, ENABLE);	/* DMA1 clock enable */

		GPIO_InitStruct.GPIO_Pin = GPIO_Pin_6 | GPIO_Pin_7;	/* 9 is Tx, 10 is Rx */
		NVIC_InitStructure.NVIC_IRQChannel = USART6_IRQn;		 /* Configure the USART1 interrupts */
		GPIOx = GPIOC;
		GPIO_PinAFConfig(GPIOx, GPIO_PinSource6, GPIO_AF_USART6);
		GPIO_PinAFConfig(GPIOx, GPIO_PinSource7, GPIO_AF_USART6);

		/* DMA: */
 
		DMA_DeInit(DMA2_Stream6);
		DMA_StructInit(&DMA_InitStructure);
		DMA_InitStructure.DMA_Channel = DMA_Channel_5;
		DMA_InitStructure.DMA_DIR = DMA_DIR_MemoryToPeripheral; /* Transmit */
		DMA_InitStructure.DMA_Memory0BaseAddr = (uint32_t)Buffer6;
		DMA_InitStructure.DMA_BufferSize = (uint16_t)sizeof(Buffer6) - 1;
		DMA_InitStructure.DMA_PeripheralBaseAddr = (uint32_t)&(USART6->DR);
		DMA_InitStructure.DMA_PeripheralInc = DMA_PeripheralInc_Disable;
		DMA_InitStructure.DMA_MemoryInc = DMA_MemoryInc_Enable;
		DMA_InitStructure.DMA_PeripheralDataSize = DMA_PeripheralDataSize_Byte;
		DMA_InitStructure.DMA_MemoryDataSize = DMA_MemoryDataSize_Byte;
		DMA_InitStructure.DMA_Mode = DMA_Mode_Normal;
		DMA_InitStructure.DMA_Priority = DMA_Priority_Low;
		DMA_InitStructure.DMA_FIFOMode = DMA_FIFOMode_Disable; /* MAYBE ENABLE */
		DMA_InitStructure.DMA_FIFOThreshold = DMA_FIFOThreshold_HalfFull; /* MAYBE FUL NOT HALFFULL */
		DMA_InitStructure.DMA_MemoryBurst = DMA_MemoryBurst_Single;
		DMA_InitStructure.DMA_PeripheralBurst = DMA_PeripheralBurst_Single;
		DMA_Init(DMA2_Stream6, &DMA_InitStructure);
		/* Enable the USART Tx DMA request */
		USART_DMACmd(USART6, USART_DMAReq_Tx, ENABLE);
		
		/* Enable DMA Stream Transfer Complete interrupt */
		DMA_ITConfig(DMA2_Stream6, DMA_IT_TC, ENABLE);
		
		/* Enable the DMA USART1 Tx Stream */
		DMA_Cmd(DMA2_Stream6, ENABLE);
	}
	else
	{
		return -1; /* Incorrect/unhandled USART port */
	}

	GPIO_InitStruct.GPIO_Mode = GPIO_Mode_AF;			/* Alternate Function so USART has access */
	GPIO_InitStruct.GPIO_OType = GPIO_OType_PP;			/* Push Pull instead of Open Drain */
	GPIO_InitStruct.GPIO_Speed = GPIO_Speed_50MHz;		/* IO speed (NOT baudrate) */
	GPIO_InitStruct.GPIO_PuPd = GPIO_PuPd_UP;			/* Pullup resistors on pins */
	GPIO_Init(GPIOx, &GPIO_InitStruct);

	USART_InitStruct.USART_BaudRate = baudrate;
	USART_InitStruct.USART_WordLength = USART_WordLength_8b;/* Data frame size is 8 bits (standard) */
	USART_InitStruct.USART_StopBits = USART_StopBits_1;		/* 1 stop bit (standard) */
	USART_InitStruct.USART_Parity = USART_Parity_No;		/* No parity bit (standard) */
	USART_InitStruct.USART_HardwareFlowControl = USART_HardwareFlowControl_None; /* No flow control (standard) */
	USART_InitStruct.USART_Mode = USART_Mode_Tx | USART_Mode_Rx; /* Enable tx and rx */
	USART_Init(USARTx, &USART_InitStruct);

	USART_ITConfig(USARTx, USART_IT_RXNE, ENABLE); // enable the USART1 receive interrupt 

	NVIC_InitStructure.NVIC_IRQChannelPreemptionPriority = 0;/* this sets the priority group of the USART1 interrupts */
	NVIC_InitStructure.NVIC_IRQChannelSubPriority = 0;		 /* this sets the subpriority inside the group */
	NVIC_InitStructure.NVIC_IRQChannelCmd = ENABLE;			 /* the USART1 interrupts are globally enabled */
	NVIC_Init(&NVIC_InitStructure);

	USART_Cmd(USARTx, ENABLE);

	return 0;
}

void DMA2_Stream7_IRQHandler(void)
{
	/* Test on DMA Stream Transfer Complete interrupt */
	if (DMA_GetITStatus(DMA2_Stream7, DMA_IT_TCIF7))
	{
		/* Clear DMA Stream Transfer Complete interrupt pending bit */
		DMA_ClearITPendingBit(DMA2_Stream7, DMA_IT_TCIF7);
	}
}

void DMA2_Stream6_IRQHandler(void)
{
	/* Test on DMA Stream Transfer Complete interrupt */
	if (DMA_GetITStatus(DMA2_Stream6, DMA_IT_TCIF6))
	{
		/* Clear DMA Stream Transfer Complete interrupt pending bit */
		DMA_ClearITPendingBit(DMA2_Stream6, DMA_IT_TCIF6);
	}
}

/*
* USART Interrupt request handler
*/
void USART1_IRQHandler(void)
{
	/* Check if the USART receive interrupt flag was set */
	if( USART_GetITStatus(USART1, USART_IT_RXNE) )
	{
		char t = USART1->DR; /* the character from the USART data register is saved in t */
		USART_ClearITPendingBit(USART1, USART_IT_RXNE);
		
	}
}

/*
* USART3 Interrupt request handler
*/
void USART3_IRQHandler(void)
{
	/* Check if the USART receive interrupt flag was set */
	if( USART_GetITStatus(USART3, USART_IT_RXNE) )
	{
		static uint8_t cnt = 0; /* this counter is used to determine the string length */
		char t = USART3->DR; /* the character from the USART data register is saved in t */

		USART_ClearITPendingBit(USART3, USART_IT_RXNE);
		
		if( ((t != '*') && (cnt < MAX_GPS_STRLEN) && (cnt > 0))
			|| ((t == '$') && (cnt == 0)) )
		{
			if(cnt == 4 && t != 'L')
			{
				cnt = 0;
			}
			else
			{
				received_string[cnt] = t;
				cnt++;
			}
		}
		// $GPGLL
		else if( ((t == '*') && (cnt > 0) && ( cnt < (MAX_GPS_STRLEN-1) )))
		{
			received_string[cnt] = t;
			received_string[++cnt] = '\0';
			memcpy(nmea_data, received_string, cnt+1);
			cnt = 0;
		}
		else
		{
			cnt = 0;
		}
	}
}

/* 
* Send data over USART1 using DMA
*/
int8_t USART1_DMAsends(char *t)
{
	uint16_t len = 0;
	if(*t == 0) return -1;
	while((USART1->SR & USART_FLAG_TC)==0); //wait for non-dma tx completion
	if(!uart1virgin)
		while(DMA_GetFlagStatus(DMA2_Stream7, DMA_FLAG_TCIF7)==0); //wait for dma tx completion
	while(USART_GetFlagStatus(USART1, USART_FLAG_TXE) == RESET);
	while(*t)
	{
		Buffer1[len++]= *t++;
		if(len == MAXUSARTBUF-1)
		{
			Buffer1[len++] = 0;
			break;
		}
	}
	DMA_InitStructure.DMA_BufferSize = DMA2_Stream7->NDTR = len;
	DMA_ClearFlag(DMA2_Stream7, DMA_FLAG_TCIF7); //clear transfer complete to allow next one
	DMA_Cmd(DMA2_Stream7, ENABLE);
	uart1virgin=0;

	return 0;
}

/* 
* Send data over USART6 using DMA
*/
int8_t USART6_DMAsends(char *t)
{
	uint16_t len = 0;
	if(*t == 0) return -1;
	while((USART6->SR & USART_FLAG_TC)==0); //wait for non-dma tx completion
	if(!uart6virgin)
		while(DMA_GetFlagStatus(DMA2_Stream6, DMA_FLAG_TCIF6)==0); //wait for dma tx completion
	while(USART_GetFlagStatus(USART6, USART_FLAG_TXE) == RESET);
	while(*t)
	{
		Buffer6[len++]= *t++;
		if(len == MAXUSARTBUF-1)
		{
			Buffer6[len++] = 0;
			break;
		}
	}
	DMA_InitStructure.DMA_BufferSize = DMA2_Stream6->NDTR = len;
	DMA_ClearFlag(DMA2_Stream6, DMA_FLAG_TCIF6); //clear transfer complete to allow next one
	DMA_Cmd(DMA2_Stream6, ENABLE);
	uart6virgin=0;

	return 0;
}

/* Send data over specified USART.
* e.g USART_sends(USART1, "Hello World!");
*/
int8_t USART_sends(USART_TypeDef* USARTx, char *pszString)
{
	if( strlen(pszString) > MAX_STRLEN )
		return -1; /* String too long */
	while(*pszString){
		/* Wait until send register is empty */
		while( !(USARTx->SR & 0x00000040) )
		{
		}			
		USART_SendData(USARTx, *pszString);
		*pszString++;
	}
	return 0;
}
