tomkentpayne/wireless_gps_tracking/Device Code/MAIN/User/gps.c

/* GPS data parsing code
* maintained by Thomas Payne tp8g10
*/

#include <stm32f4xx.h>
#include <stdio.h>

#include "globals.h"
#include <string.h>
#include <stdlib.h>
#include "serial.h"

//#define MESSAGE_FIX "$GPGLL,5056.27340,N,00123.88000,W,104503.00,A,A*"

static double latDeg;
static double longDeg;
static char GPSnmea_data[MAX_GPS_STRLEN];

/*
* Parses NMEA GPS strings to obtain lat/long.
* Probably called from a timer and executed before lat/long is logged.
*/
int8_t ParseNMEA(/*char* nmea_data*/void)
{
	memcpy(&GPSnmea_data[0], NMEA_data(), MAX_GPS_STRLEN);
	/* Start of GPS message */
	if( (GPSnmea_data[0] == '$') && (GPSnmea_data[1] == 'G') && (GPSnmea_data[2] == 'P') )
	{
		/* Geographic Latitude and Longitude data */
		if( (GPSnmea_data[3] == 'G') && (GPSnmea_data[4] == 'L') && (GPSnmea_data[5] == 'L') )
		{
			double latMins;
			double longMins;
			char tokens[7][16]; /* NMEA data sections, 7 including the * */
			char degrees[4]; /* max 3 digits + \0 */
			char *tmp;
			uint8_t index = 0;
			uint32_t decimalIndex;
			tmp = strtok(&GPSnmea_data[6], ",*"); /* Splits based on delimiter ',' */
			while(tmp != NULL)
			{
				strncpy(tokens[index++], tmp, 16);
				tmp = strtok(NULL, ",*");
			}
			
			if(index < 5)
			{
				return -1; /* NO FIX */
			}

			decimalIndex = strcspn(tokens[0], "."); /* Finds decimal point in token for lat */
			latMins = strtod((tokens[0] + decimalIndex - 2), NULL); /* copies minutes from around the xx'.'xx(x) */
			memcpy(degrees, tokens[0], decimalIndex - 2); /* Copy out Degrees part of token, 2 or 3 bytes */
			degrees[decimalIndex - 2] = '\0'; /* Terminate string */
			latDeg = strtod(degrees, NULL);  /* Get degrees */
			if(tokens[1][0] == 'S') /* Maybe use strcomp() instead */
			{
				/* Lat is negative */
				latDeg = -latDeg;
				latMins = -latMins;
			}
			latDeg = latDeg + latMins / 60.0; /* Convert degrees/minutes to degrees */

			decimalIndex = strcspn(tokens[2], "."); /* Finds decimal point in token for lat */
			longMins = strtod(tokens[2] + decimalIndex - 2, NULL); /* copies minutes from around the xx'.'xx(x) */
			memcpy(degrees, tokens[2], decimalIndex - 2); /* Copy out Degrees part of token, 2 or 3 bytes */
			degrees[decimalIndex - 2] = '\0'; /* Terminate string */
			longDeg = strtod(degrees, NULL); /* Get degrees */
			if(tokens[3][0] == 'W') /* Maybe use strcomp() instead */
			{
				/* Lat is negative */
				longDeg = -longDeg;
				longMins = -longMins;
			}
			longDeg = longDeg + longMins / 60.0; /* Convert degrees/minutes to degrees */
			
			/*
			* ",xx(x)xx.xx(x),N,xx(x)xx.xx(x),W,xxxxxx,A,*"(\0 included)
			* xx(x)|xx.xx(x) is degrees|minutes
			* tokens are everything between ','s
			* Decimal Degrees = Degrees + minutes/60 + seconds/3600
			*/
		}
		else
			return -1; /* Not Lat/Long data */
	}
	else
		return -1; /* Not GPS data */
	return 0;
}

double GetLat(void)
{
	return latDeg;
}

double GetLong(void)
{
	return longDeg;
}
