tomkentpayne/wireless_gps_tracking/(commit log)

2013-12-06 Complete stm32 code folder
    Ready to go
2013-12-23 Added Eagle design files and Gerbers
    [car.GBL, car.GBO, car.GBP, car.GBS, car.GTL, car.GTO, car.GTP, car.GTS]
2014-01-12 GPS data receive handler
    Rx pin still currently set to USB not GPS
2014-01-13 UART tessting structure + project
    also gpio testing fix and MAIN project file update (assuming no one's
    touched so is ok)
    [main.c]
2014-01-15 Todays stuff (timer, gpio)
2014-01-19 LED flashes when no gps fix, else on
    [gpio.c, gpio.h, main.c, timer.c]
